flesniak/avr-djc/README.md

avr-djc
=======

Firmware for self-made MIDI DJ controller using AVR µC and V-USB
