flesniak/avr-djc/(threads)

Thread 1 (2020-02-21):

Need help

4dvn, 2020-02-21:
Can you upload the schematic and image of this board?

flesniak, 2020-02-23:
Sure, I just added schematic and board files in commit e737ecb69fb5c8c25f893. Beware that these files may contain errors and should be used for referene only, as they were just used for one prototype.

Closed 2020-02-23.
