flesniak/avr-djc/hw/buttonboard-center.brd

## EAGLE design hw/buttonboard-center.brd (2020-02-23)

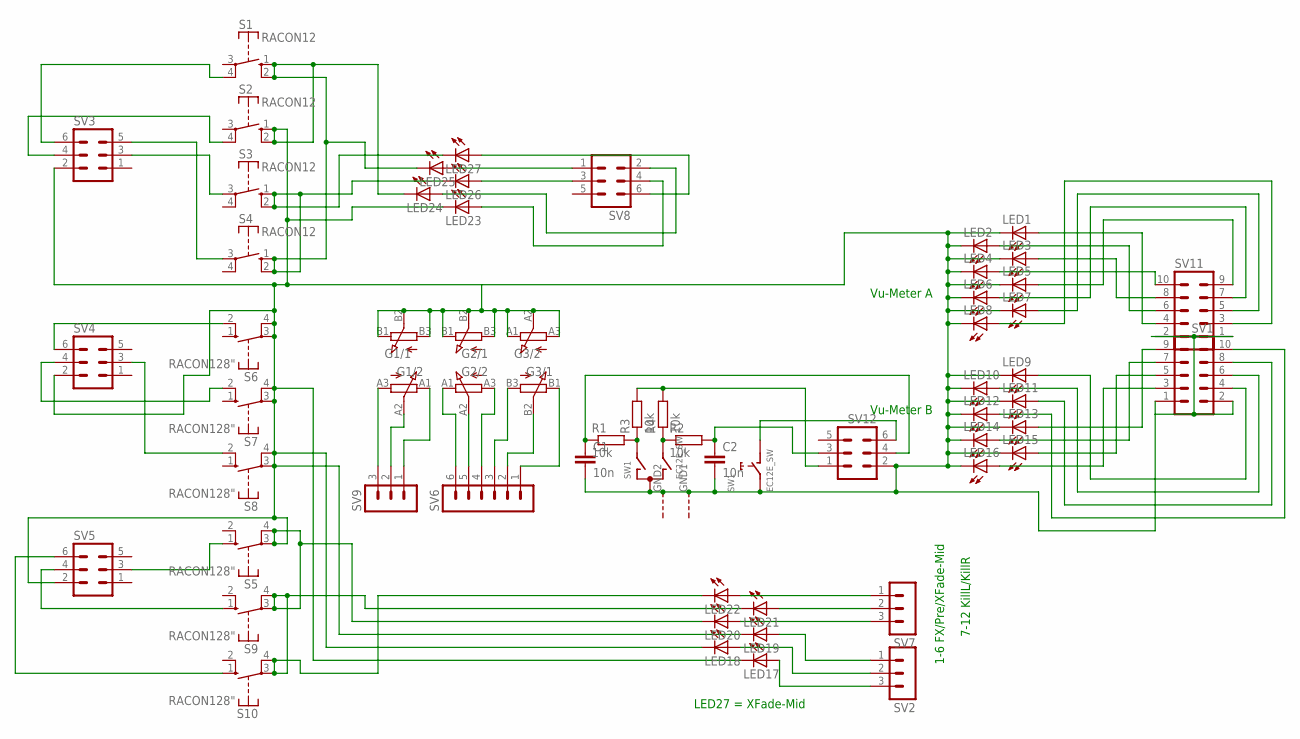
[picture p1: schematic buttonboard-center.sch]

Parts:
C1, C2: 10n; C025-025X050
G1, G2, G3: RS60112RS; RS60112
LED1, LED2, LED3, LED4, LED5, LED6, LED7, LED8, LED9, LED10, LED11, LED12, LED13, LED14, LED15, LED16, LED17, LED18, LED19, LED20, LED21, LED22, LED23, LED24, LED25, LED26, LED27: LED3MM
R1, R2, R3, R4: 10k; 0207/7
S1, S2, S3, S4: RACON12
S5, S6, S7, S8, S9, S10: RACON128"; RACON8
SV1, SV11: MA05-2
SV2, SV7, SV9: MA03-1
SV3, SV4, SV5, SV8, SV12: MA03-2
SV6: MA06-1
SW1: EC12E_SW; ALPS_EC12E_SW

Connections:
GND: C1.2, C2.2, G1.B1 (E), G1.B2 (S), G1.B3 (A), G2.B1 (E), G2.B2 (S), G2.B3 (A), G3.A1 (E), G3.A2 (S), G3.A3 (A), LED1.K (C), LED2.K (C), LED3.K (C), LED4.K (C), LED5.K (C), LED6.K (C), LED7.K (C), LED8.K (C), LED9.K (C), LED10.K (C), LED11.K (C), LED12.K (C), LED13.K (C), LED14.K (C), LED15.K (C), LED16.K (C), LED17.K (C), LED18.K (C), LED19.K (C), LED20.K (C), LED21.K (C), LED22.K (C), LED23.K (C), LED24.K (C), LED25.K (C), LED26.K (C), LED27.K (C), S1.1 (S), S1.2 (S), S2.1 (S), S2.2 (S), S3.1 (S), S3.2 (S), S4.1 (S), S4.2 (S), S5.3, S5.4, S6.3, S6.4, S7.3, S7.4, S8.3, S8.4, S9.3, S9.4, S10.3, S10.4, SV1.1, SV1.2, SV3.2, SV4.2, SV5.2, SV11.1, SV11.2, SV12.2, SW1.C, SW1.E (2), SW1.GND1 (G), SW1.GND2 (G)
unnamed: R1.2, R3.1, SW1.A
unnamed: LED16.A, SV1.3
unnamed: LED15.A, SV1.5
unnamed: LED14.A, SV1.7
unnamed: LED13.A, SV1.9
unnamed: LED12.A, SV1.10
unnamed: LED11.A, SV1.8
unnamed: LED10.A, SV1.6
unnamed: LED9.A, SV1.4
unnamed: LED8.A, SV11.3
unnamed: LED7.A, SV11.5
unnamed: LED6.A, SV11.7
unnamed: LED5.A, SV11.9
unnamed: LED4.A, SV11.10
unnamed: LED3.A, SV11.8
unnamed: R2.1, R4.1, SW1.B
unnamed: C1.1, R1.1, SV12.4
unnamed: LED2.A, SV11.6
unnamed: LED1.A, SV11.4
unnamed: LED17.A, SV2.3
unnamed: LED18.A, SV2.2
unnamed: LED19.A, SV2.1
unnamed: LED20.A, SV7.3
unnamed: LED21.A, SV7.2
unnamed: LED22.A, SV7.1
unnamed: LED24.A, SV8.2
unnamed: SV12.6, SW1.D (1)
unnamed: LED25.A, SV8.1
unnamed: S3.3, SV3.3
unnamed: LED23.A, SV8.4
unnamed: S2.4, SV3.4
unnamed: S1.4, SV3.6
unnamed: C2.1, R2.2, SV12.3
unnamed: R3.2, R4.2, SV12.1
unnamed: LED26.A, SV8.3
unnamed: S6.2 (S), SV4.6
unnamed: LED27.A, SV8.6
unnamed: S4.3, SV3.5
unnamed: S5.1 (S), SV5.3
unnamed: G1.A3 (A), SV9.3
unnamed: G1.A2 (S), SV9.2
unnamed: G1.A1 (E), SV9.1
unnamed: G2.A1 (E), SV6.6
unnamed: G2.A2 (S), SV6.5
unnamed: G2.A3 (A), SV6.4
unnamed: G3.B3 (A), SV6.3
unnamed: G3.B2 (S), SV6.2
unnamed: G3.B1 (E), SV6.1
unnamed: S9.1 (S), SV5.4
unnamed: S7.2 (S), SV4.4
unnamed: S8.2 (S), SV4.3
unnamed: S10.1 (S), SV5.6

Notes on the sheet:
Vu-Meter A
Vu-Meter B
LED27 = XFade-Mid
1-6 FX/Pre/XFade-Mid
7-12 KillL/KillR

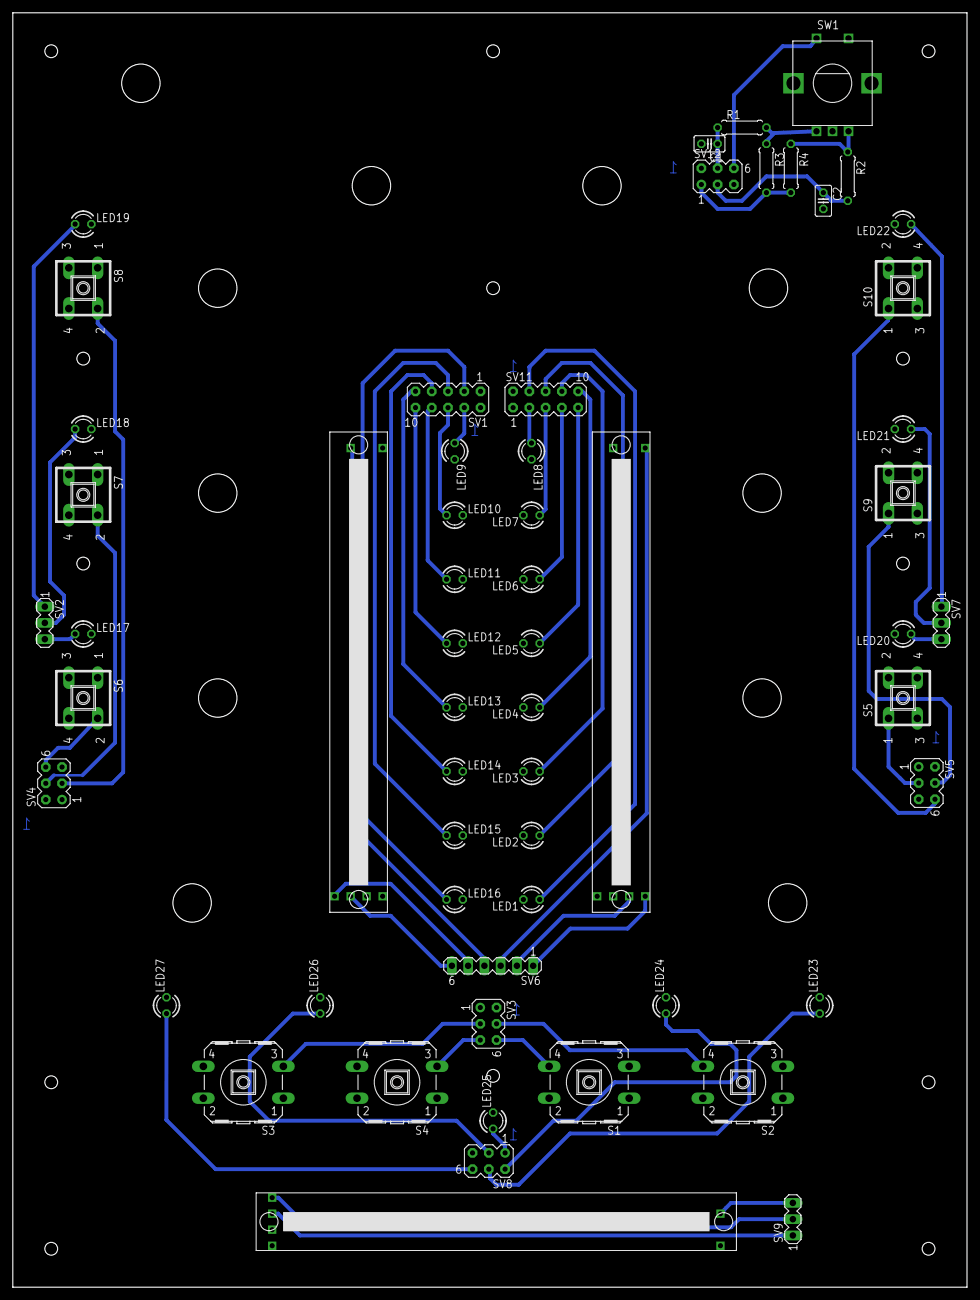
[picture p2: board buttonboard-center.brd from above]

Board: 2 copper layers, 149.0 x 199.0 mm, 58 parts (0 on the bottom side), 53 nets.
