flesniak/avr-djc/hw/main.brd

## EAGLE design hw/main.brd (2020-02-23)

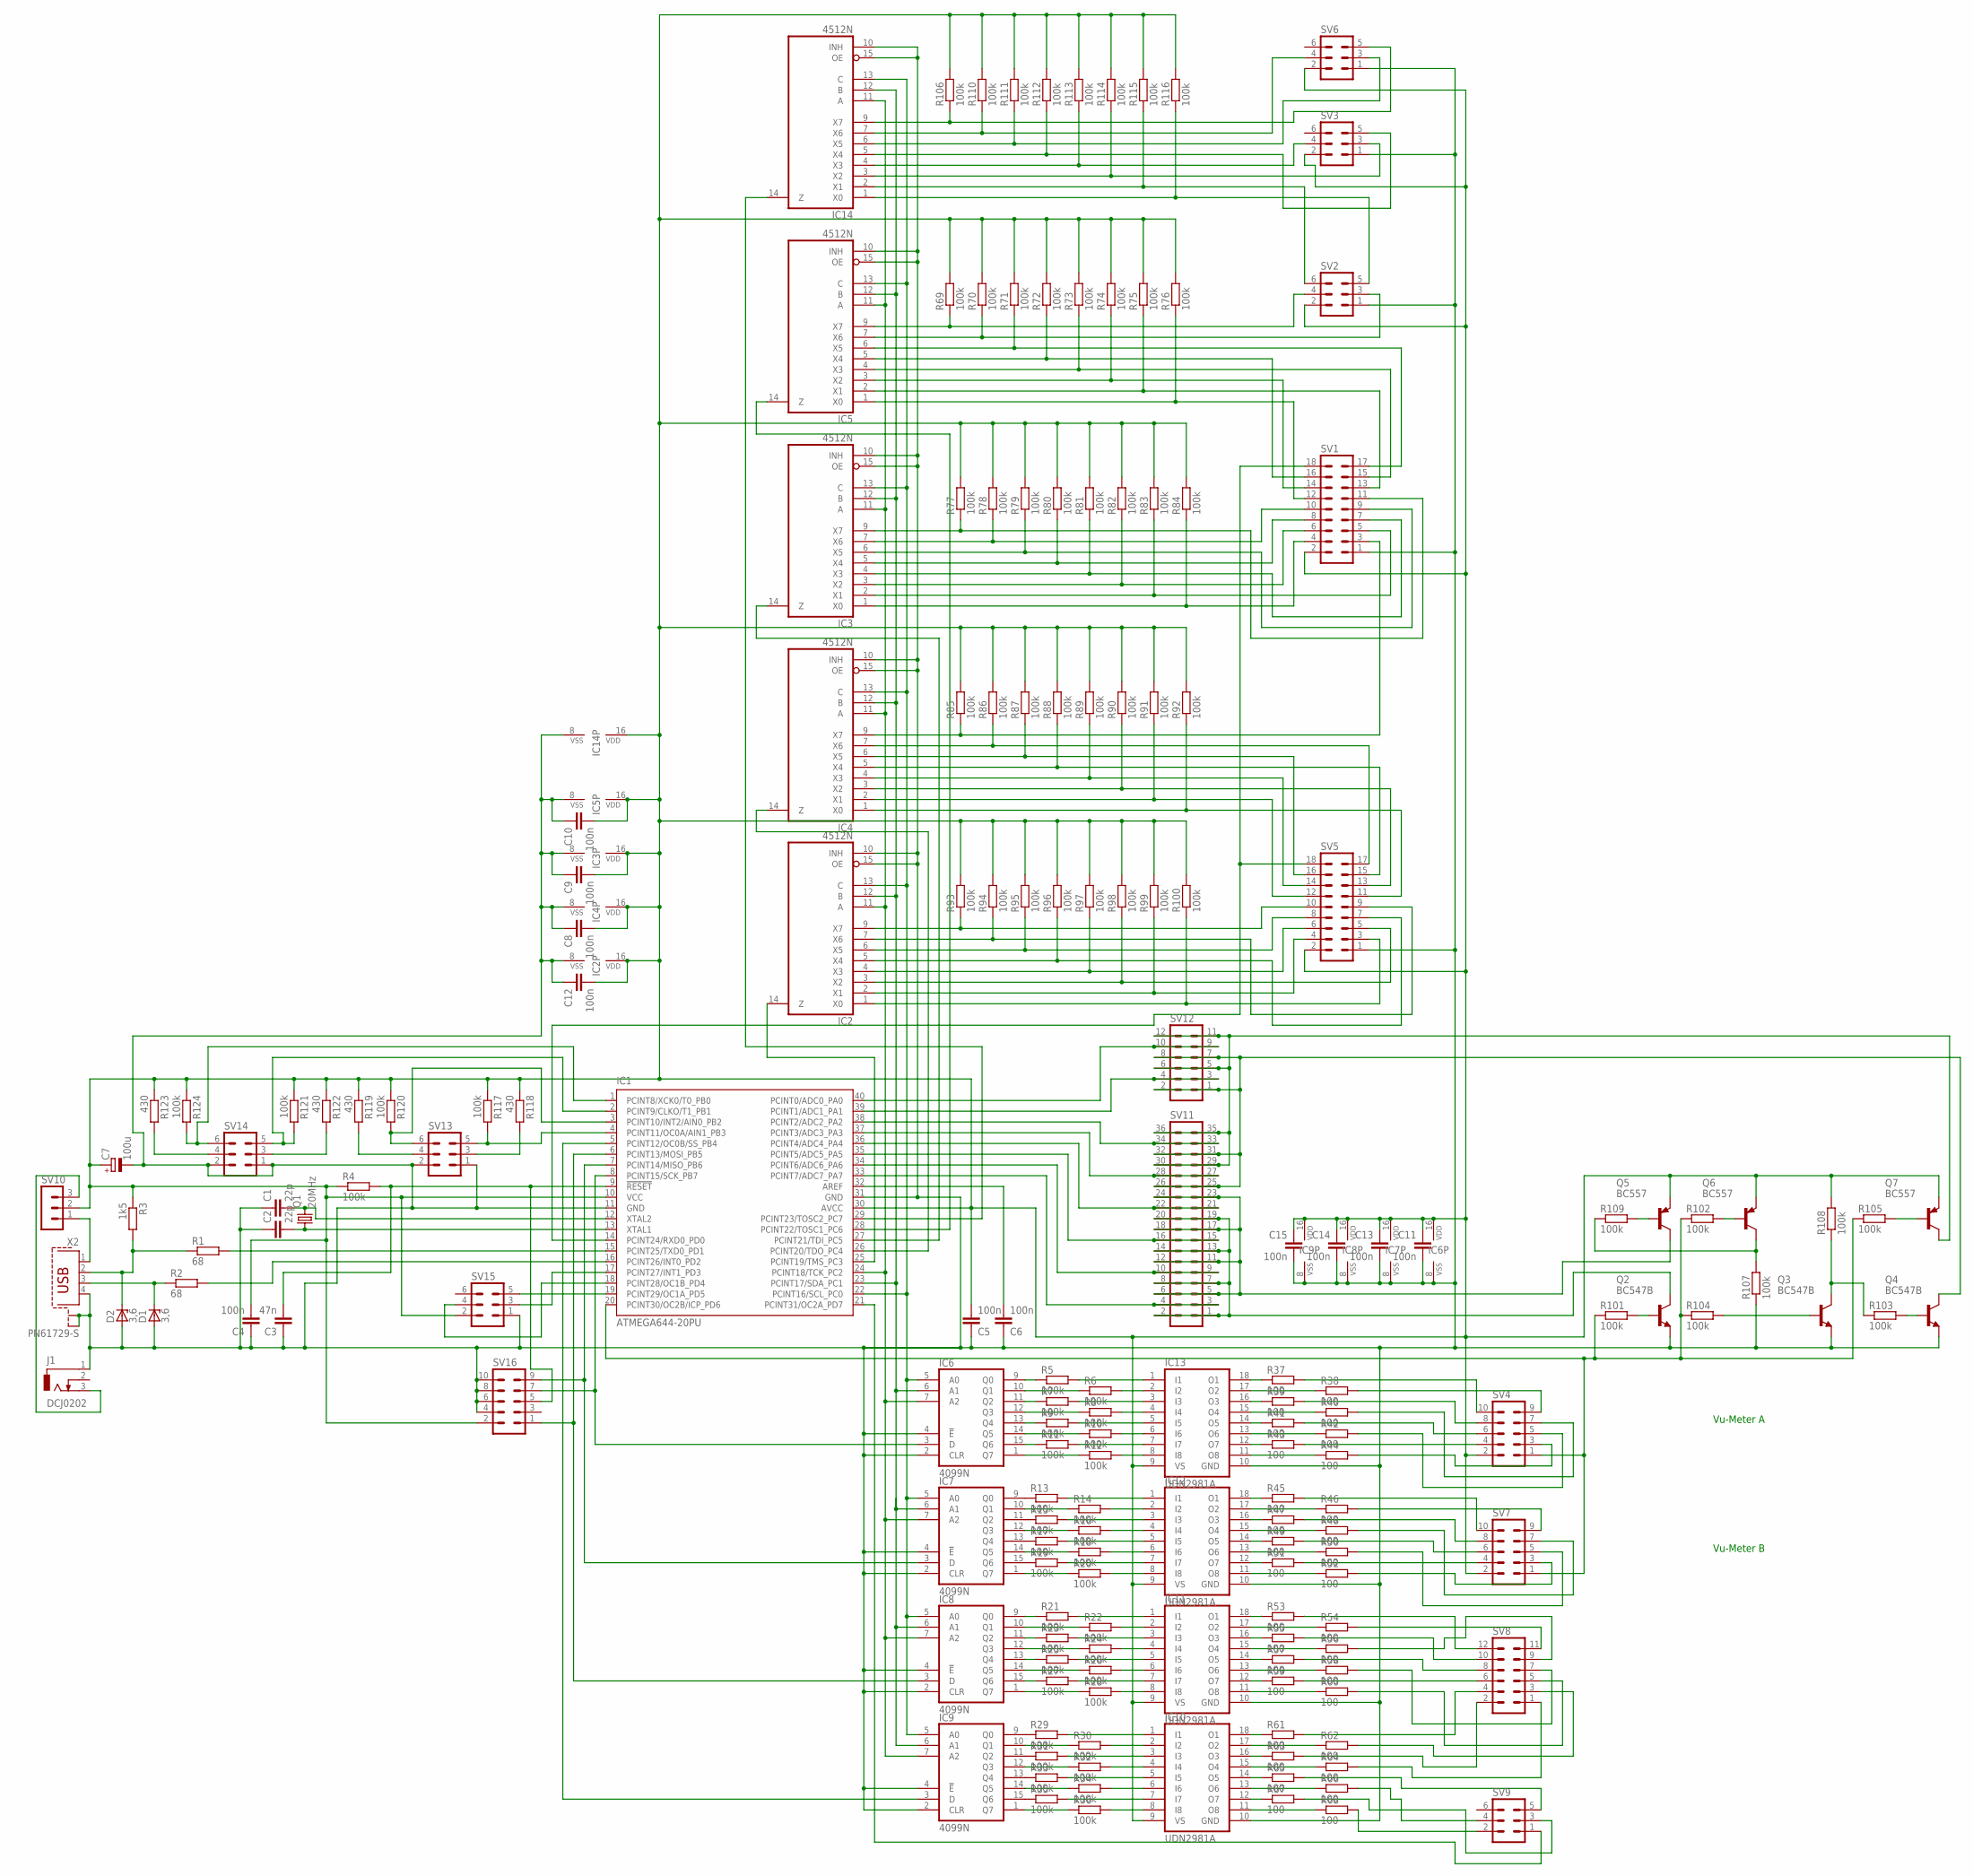
[picture p3: schematic main.sch]

Parts:
C1, C2: 22p; C025-024X044
C3: 47n; C025-024X044
C4, C5, C6, C8, C9, C10, C11, C12, C13, C14, C15: 100n; C025-024X044
C7: 100u; E3,5-8
D1, D2: 3,6; DO34Z7
IC1: ATMEGA644-20PU; DIL40
IC2, IC3, IC4, IC5, IC14: 4512N; DIL16
IC6, IC7, IC8, IC9: 4099N; DIL16
IC10, IC11, IC12, IC13: UDN2981A; DIL18
J1: DCJ0202
Q1: 20MHz; HC18U-V
Q2, Q3, Q4: BC547B; TO92
Q5, Q6, Q7: BC557; TO92
R1, R2: 68; 0204/7
R3: 1k5; 0204/7
R4, R5, R6, R7, R8, R9, R10, R11, R12, R13, R14, R15, R16, R17, R18, R19, R20, R21, R22, R23, R24, R25, R26, R27, R28, R29, R30, R31, R32, R33, R34, R35, R36, R69, R70, R71, R72, R73, R74, R75, R76, R77, R78, R79, R80, R81, R82, R83, R84, R85, R86, R87, R88, R89, R90, R91, R92, R93, R94, R95, R96, R97, R98, R99, R100, R101, R102, R103, R104, R105, R106, R107, R108, R109, R110, R111, R112, R113, R114, R115, R116, R117, R120, R121, R124: 100k; 0204/7
R37, R38, R39, R40, R41, R42, R43, R44, R45, R46, R47, R48, R49, R50, R51, R52, R53, R54, R55, R56, R57, R58, R59, R60, R61, R62, R63, R64, R65, R66, R67, R68: 100; 0204/7
R118, R119, R122, R123: 430; 0204/7
SV1, SV5: MA09-2
SV2, SV3, SV6, SV9, SV13, SV14, SV15: MA03-2
SV4, SV7, SV16: MA05-2
SV8, SV12: MA06-2
SV10: MA03-1
SV11: MA18-2
X2: PN61729-S

Connections:
GND: C1.1, C2.1, C3.1, C4.1, C5.1, C6.1, C7.-, C8.1, C9.1, C10.1, C11.2, C12.1, C13.2, C14.2, C15.2, D1.A, D2.A, IC1.11 (GND), IC1.31 (GND), IC2.8 (VSS), IC2.10 (INH), IC2.15 (OE), IC3.8 (VSS), IC3.10 (INH), IC3.15 (OE), IC4.8 (VSS), IC4.10 (INH), IC4.15 (OE), IC5.8 (VSS), IC5.10 (INH), IC5.15 (OE), IC6.2 (CLR), IC6.4 (!E), IC6.8 (VSS), IC7.2 (CLR), IC7.4 (!E), IC7.8 (VSS), IC8.2 (CLR), IC8.4 (!E), IC8.8 (VSS), IC9.2 (CLR), IC9.4 (!E), IC9.8 (VSS), IC10.10 (GND), IC11.10 (GND), IC12.10 (GND), IC13.10 (GND), IC14.8 (VSS), IC14.10 (INH), IC14.15 (OE), J1.1, Q2.1 (E), Q3.1 (E), Q4.1 (E), R107.1, SV1.1, SV2.1, SV3.1, SV5.1, SV6.1, SV13.1, SV13.2, SV14.1, SV14.2, SV15.1, SV16.4, SV16.6, SV16.8, SV16.10, X2.4, X2.S1, X2.S2
unnamed: IC4.9 (X7), R85.1, SV1.3
unnamed: C2.2, IC1.13 (XTAL1), Q1.1
unnamed: C1.2, IC1.12 (XTAL2), Q1.2
unnamed: IC1.14 (PCINT24/RXD0_PD0), SV1.18, SV5.18
unnamed: D1.C, R2.1, X2.3
unnamed: D2.C, R1.1, R3.2, X2.2
unnamed: IC1.16 (PCINT26/INT0_PD2), R2.2
unnamed: IC1.15 (PCINT25/TXD0_PD1), R1.2
unnamed: C3.2, IC1.9 (!RESET), R4.2, SV16.5
unnamed: IC7.9 (Q0), R13.1
unnamed: IC7.11 (Q2), R15.1
unnamed: C6.2, IC1.32 (AREF)
unnamed: IC7.13 (Q4), R17.1
unnamed: IC7.15 (Q6), R19.1
unnamed: IC1.6 (PCINT13/MOSI_PB5), IC8.3 (D), SV16.1
unnamed: IC1.5 (PCINT12/OC0B/SS_PB4), IC9.3 (D)
unnamed: IC1.23 (PCINT17/SDA_PC1), IC2.12 (B), IC3.12 (B), IC4.12 (B), IC5.12 (B), IC6.6 (A1), IC7.6 (A1), IC8.6 (A1), IC9.6 (A1), IC14.12 (B)
unnamed: IC1.22 (PCINT16/SCL_PC0), IC2.13 (C), IC3.13 (C), IC4.13 (C), IC5.13 (C), IC6.5 (A0), IC7.5 (A0), IC8.5 (A0), IC9.5 (A0), IC14.13 (C)
unnamed: IC1.24 (PCINT18/TCK_PC2), IC2.11 (A), IC3.11 (A), IC4.11 (A), IC5.11 (A), IC6.7 (A2), IC7.7 (A2), IC8.7 (A2), IC9.7 (A2), IC14.11 (A)
unnamed: IC8.9 (Q0), R21.1
unnamed: IC8.10 (Q1), R22.1
unnamed: IC8.11 (Q2), R23.1
unnamed: IC8.12 (Q3), R24.1
unnamed: IC1.27 (PCINT21/TDI_PC5), IC3.14 (Z)
unnamed: IC1.25 (PCINT19/TMS_PC3), IC2.14 (Z)
unnamed: IC3.6 (X5), R79.1, SV1.9
unnamed: IC3.9 (X7), R77.1, SV1.11
unnamed: IC12.12 (O7), R51.1
unnamed: IC8.13 (Q4), R25.1
unnamed: IC8.14 (Q5), R26.1
unnamed: IC8.15 (Q6), R27.1
unnamed: IC8.1 (Q7), R28.1
unnamed: IC13.8 (I8), R12.2
unnamed: IC13.7 (I7), R11.2
unnamed: IC13.6 (I6), R10.2
unnamed: IC13.5 (I5), R9.2
unnamed: IC13.4 (I4), R8.2
unnamed: IC13.3 (I3), R7.2
unnamed: IC13.2 (I2), R6.2
unnamed: IC13.1 (I1), R5.2
unnamed: IC10.1 (I1), R29.2
unnamed: IC10.2 (I2), R30.2
unnamed: IC10.3 (I3), R31.2
unnamed: IC10.4 (I4), R32.2
unnamed: IC10.5 (I5), R33.2
unnamed: IC10.6 (I6), R34.2
unnamed: IC10.7 (I7), R35.2
unnamed: IC10.8 (I8), R36.2
unnamed: IC9.10 (Q1), R30.1
unnamed: IC9.12 (Q3), R32.1
unnamed: IC9.14 (Q5), R34.1
unnamed: IC9.1 (Q7), R36.1
unnamed: IC11.1 (I1), R21.2
unnamed: IC9.9 (Q0), R29.1
unnamed: IC9.11 (Q2), R31.1
unnamed: IC1.28 (PCINT22/TOSC1_PC6), IC5.14 (Z)
unnamed: IC1.26 (PCINT20/TDO_PC4), IC4.14 (Z)
unnamed: IC9.13 (Q4), R33.1
unnamed: IC11.2 (I2), R22.2
unnamed: IC9.15 (Q6), R35.1
unnamed: IC11.3 (I3), R23.2
unnamed: IC11.4 (I4), R24.2
unnamed: IC1.8 (PCINT15/SCK_PB7), IC6.3 (D), SV16.7
unnamed: IC1.7 (PCINT14/MISO_PB6), IC7.3 (D), SV16.9
unnamed: IC11.5 (I5), R25.2
unnamed: IC11.6 (I6), R26.2
unnamed: IC11.7 (I7), R27.2
unnamed: IC6.9 (Q0), R5.1
unnamed: IC6.10 (Q1), R6.1
unnamed: IC6.11 (Q2), R7.1
unnamed: IC6.12 (Q3), R8.1
unnamed: IC6.13 (Q4), R9.1
unnamed: IC6.14 (Q5), R10.1
unnamed: IC6.15 (Q6), R11.1
unnamed: IC6.1 (Q7), R12.1
unnamed: IC11.8 (I8), R28.2
unnamed: IC13.18 (O1), R37.1
unnamed: IC13.17 (O2), R38.1
unnamed: R37.2, SV4.10
unnamed: R38.2, SV4.9
unnamed: IC5.9 (X7), R69.1, SV2.4
unnamed: R53.2, SV8.12
unnamed: R39.2, SV4.8
unnamed: IC12.1 (I1), R13.2
unnamed: IC12.2 (I2), R14.2
unnamed: IC12.3 (I3), R15.2
unnamed: IC12.4 (I4), R16.2
unnamed: IC12.5 (I5), R17.2
unnamed: IC12.6 (I6), R18.2
unnamed: IC12.7 (I7), R19.2
unnamed: IC12.8 (I8), R20.2
unnamed: IC7.10 (Q1), R14.1
unnamed: IC7.12 (Q3), R16.1
unnamed: IC13.16 (O3), R39.1
unnamed: IC13.15 (O4), R40.1
unnamed: R40.2, SV4.7
unnamed: R41.2, SV4.6
unnamed: IC5.6 (X5), R71.1, SV1.17
unnamed: IC7.14 (Q5), R18.1
unnamed: IC7.1 (Q7), R20.1
unnamed: IC3.4 (X3), R81.1, SV1.7
unnamed: IC13.14 (O5), R41.1
unnamed: IC13.13 (O6), R42.1
unnamed: R42.2, SV4.5
unnamed: R43.2, SV4.4
unnamed: IC5.4 (X3), R73.1, SV1.15
unnamed: IC3.2 (X1), R83.1, SV1.5
unnamed: IC13.12 (O7), R43.1
unnamed: IC13.11 (O8), R44.1
unnamed: IC12.13 (O6), R50.1
unnamed: IC5.2 (X1), R75.1, SV1.13
unnamed: R54.2, SV8.11
unnamed: IC3.3 (X2), R82.1, SV1.6
unnamed: IC12.18 (O1), R45.1
unnamed: IC12.17 (O2), R46.1
unnamed: R44.2, SV4.3
unnamed: J1.3, SV10.3
unnamed: IC12.16 (O3), R47.1
unnamed: IC12.15 (O4), R48.1
unnamed: R45.2, SV7.10
unnamed: R46.2, SV7.9
unnamed: IC12.14 (O5), R49.1
unnamed: IC11.12 (O7), R59.1
unnamed: R47.2, SV7.8
unnamed: R48.2, SV7.7
unnamed: R55.2, SV8.10
unnamed: R49.2, SV7.6
unnamed: R50.2, SV7.5
unnamed: IC12.11 (O8), R52.1
unnamed: R51.2, SV7.4
unnamed: IC11.18 (O1), R53.1
unnamed: IC11.17 (O2), R54.1
unnamed: R52.2, SV7.3
unnamed: IC5.7 (X6), R70.1, SV2.3
unnamed: IC11.16 (O3), R55.1
unnamed: IC11.15 (O4), R56.1
unnamed: IC1.33 (PCINT7/ADC7_PA7), SV11.3, SV11.4
unnamed: IC3.1 (X0), R84.1, SV1.4
unnamed: IC11.14 (O5), R57.1
unnamed: IC11.13 (O6), R58.1
unnamed: R56.2, SV8.9
unnamed: R57.2, SV8.8
unnamed: R58.2, SV8.7
unnamed: R59.2, SV8.6
unnamed: R60.2, SV8.5
unnamed: IC11.11 (O8), R60.1
unnamed: R61.2, SV8.4
unnamed: IC10.18 (O1), R61.1
unnamed: IC10.17 (O2), R62.1
unnamed: R62.2, SV8.3
unnamed: IC1.34 (PCINT6/ADC6_PA6), SV11.9, SV11.10
unnamed: IC10.16 (O3), R63.1
unnamed: IC10.15 (O4), R64.1
unnamed: IC4.7 (X6), R86.1, SV5.17
unnamed: IC4.6 (X5), R87.1, SV5.16
unnamed: IC10.14 (O5), R65.1
unnamed: IC10.13 (O6), R66.1
unnamed: IC4.5 (X4), R88.1, SV5.15
unnamed: IC4.4 (X3), R89.1, SV5.14
unnamed: IC10.12 (O7), R67.1
unnamed: IC4.3 (X2), R90.1, SV5.13
unnamed: IC1.29 (PCINT23/TOSC2_PC7), IC14.14 (Z)
unnamed: IC10.11 (O8), R68.1
unnamed: IC5.5 (X4), R72.1, SV1.16
unnamed: IC4.2 (X1), R91.1, SV5.12
unnamed: R63.2, SV8.2
unnamed: IC4.1 (X0), R92.1, SV5.11
unnamed: IC2.9 (X7), R93.1, SV5.10
unnamed: IC2.7 (X6), R94.1, SV5.9
unnamed: IC2.6 (X5), R95.1, SV5.8
unnamed: IC14.9 (X7), R106.1, SV6.5
unnamed: IC2.5 (X4), R96.1, SV5.7
unnamed: IC14.7 (X6), R110.1, SV6.4
unnamed: IC14.6 (X5), R111.1, SV6.3
unnamed: IC14.4 (X3), R113.1, SV3.4
unnamed: IC14.2 (X1), R115.1, SV2.6
unnamed: IC2.4 (X3), R97.1, SV5.6
unnamed: IC2.3 (X2), R98.1, SV5.5
unnamed: R64.2, SV8.1
unnamed: IC2.2 (X1), R99.1, SV5.4
unnamed: R65.2, SV9.5
unnamed: IC2.1 (X0), R100.1, SV5.3
unnamed: R66.2, SV9.4
unnamed: IC3.7 (X6), R78.1, SV1.10
unnamed: IC1.20 (PCINT30/OC2B/ICP_PD6), R101.1, R102.1, R104.1, R105.1, SV4.1, SV7.1
unnamed: Q6.2 (B), R102.2
unnamed: R67.2, SV9.3
unnamed: IC14.5 (X4), R112.1, SV3.5
unnamed: Q7.2 (B), R105.2
unnamed: IC14.3 (X2), R114.1, SV3.3
unnamed: IC14.1 (X0), R116.1, SV2.5
unnamed: Q2.2 (B), R101.2
unnamed: R68.2, SV9.2
unnamed: IC3.5 (X4), R80.1, SV1.8
unnamed: Q3.2 (B), R104.2
unnamed: Q6.3 (C), R107.2, R109.1
unnamed: Q3.3 (C), R103.1, R108.1
unnamed: Q4.2 (B), R103.2
unnamed: Q5.2 (B), R109.2
unnamed: IC1.21 (PCINT31/OC2A_PD7), SV9.1
unnamed: IC1.4 (PCINT11/OC0A/AIN1_PB3), R117.2, SV13.5
unnamed: R118.2, SV13.3
unnamed: IC1.3 (PCINT10/INT2/AIN0_PB2), R120.2, SV13.6
unnamed: IC1.35 (PCINT5/ADC5_PA5), SV11.15, SV11.16
unnamed: R119.2, SV13.4
unnamed: IC1.2 (PCINT9/CLKO/T1_PB1), R121.2, SV14.5
unnamed: R122.2, SV14.3
unnamed: IC1.1 (PCINT8/XCK0/T0_PB0), R124.2, SV14.6
unnamed: SV10.1, X2.1
unnamed: IC1.36 (PCINT4/ADC4_PA4), SV11.21, SV11.22
unnamed: IC1.37 (PCINT3/ADC3_PA3), SV11.27, SV11.28
unnamed: R123.2, SV14.4
unnamed: IC1.38 (PCINT2/ADC2_PA2), SV11.33, SV11.34
unnamed: IC5.3 (X2), R74.1, SV1.14
unnamed: IC1.39 (PCINT1/ADC1_PA1), SV12.3, SV12.4
unnamed: IC5.1 (X0), R76.1, SV1.12
unnamed: IC1.40 (PCINT0/ADC0_PA0), SV12.9, SV12.10
unnamed: Q4.3 (C), SV11.25, SV11.26, SV11.31, SV11.32, SV12.1, SV12.2, SV12.7, SV12.8
unnamed: IC1.18 (PCINT28/OC1B_PD4), SV15.4
unnamed: IC1.19 (PCINT29/OC1A_PD5), SV15.5
unnamed: IC1.17 (PCINT27/INT1_PD3), SV15.3
unnamed: Q5.3 (C), SV11.5, SV11.6, SV11.11, SV11.12, SV11.17, SV11.18, SV11.23, SV11.24
unnamed: Q2.3 (C), SV11.1, SV11.2, SV11.7, SV11.8, SV11.13, SV11.14, SV11.19, SV11.20
unnamed: Q7.3 (C), SV11.29, SV11.30, SV11.35, SV11.36, SV12.5, SV12.6, SV12.11, SV12.12
VCC: C4.2, C5.2, C7.+, C8.2, C9.2, C10.2, C11.1, C12.2, C13.1, C14.1, C15.1, IC1.10 (VCC), IC1.30 (AVCC), IC2.16 (VDD), IC3.16 (VDD), IC4.16 (VDD), IC5.16 (VDD), IC6.16 (VDD), IC7.16 (VDD), IC8.16 (VDD), IC9.16 (VDD), IC10.9 (VS), IC11.9 (VS), IC12.9 (VS), IC13.9 (VS), IC14.16 (VDD), Q5.1 (E), Q6.1 (E), Q7.1 (E), R3.1, R4.1, R69.2, R70.2, R71.2, R72.2, R73.2, R74.2, R75.2, R76.2, R77.2, R78.2, R79.2, R80.2, R81.2, R82.2, R83.2, R84.2, R85.2, R86.2, R87.2, R88.2, R89.2, R90.2, R91.2, R92.2, R93.2, R94.2, R95.2, R96.2, R97.2, R98.2, R99.2, R100.2, R106.2, R108.2, R110.2, R111.2, R112.2, R113.2, R114.2, R115.2, R116.2, R117.1, R118.1, R119.1, R120.1, R121.1, R122.1, R123.1, R124.1, SV1.2, SV2.2, SV3.2, SV4.2, SV5.2, SV6.2, SV7.2, SV10.2, SV15.2, SV16.2

Notes on the sheet:
Vu-Meter A
Vu-Meter B

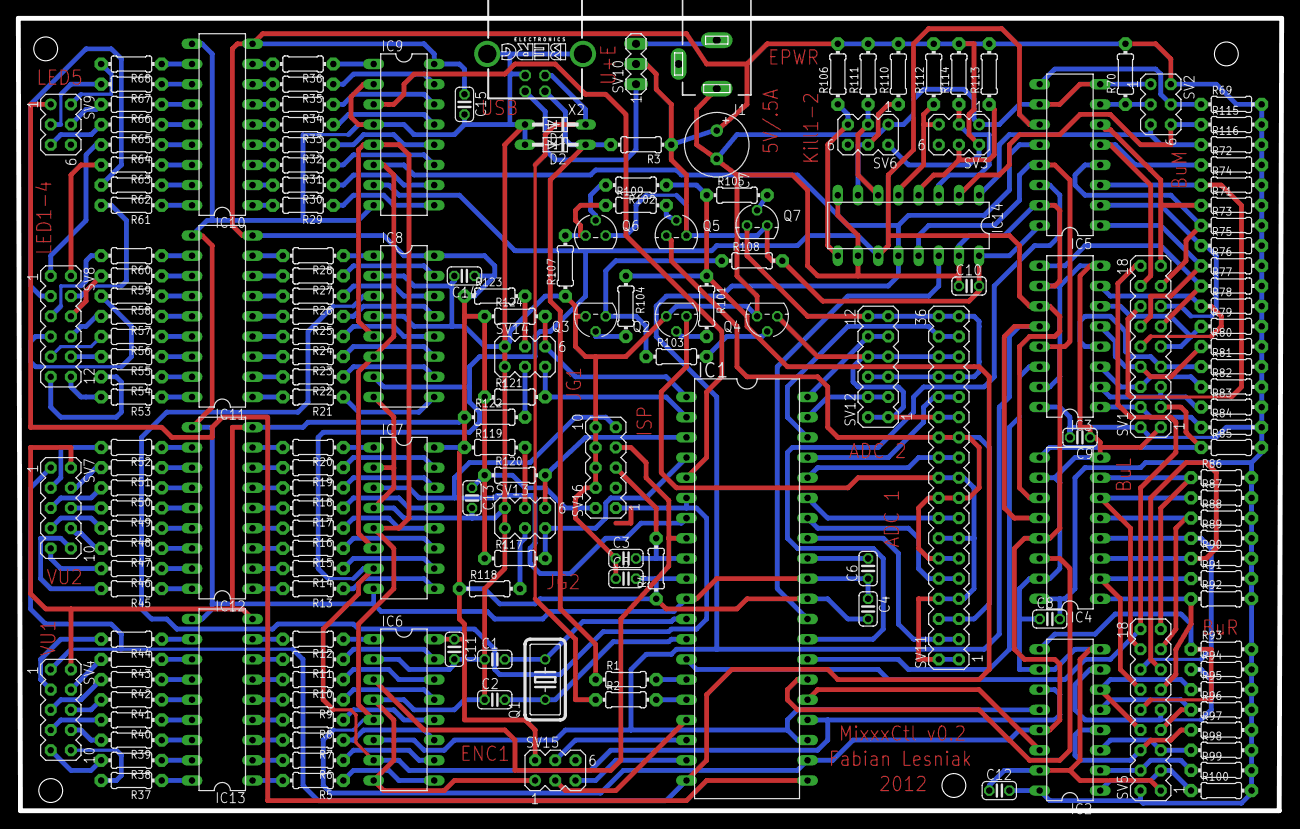
[picture p4: board main.brd from above]

Board: 2 copper layers, 159.0 x 99.7 mm, 180 parts (0 on the bottom side), 226 nets.
