flesniak/avr-djc/hw/buttonboard-right.brd

## EAGLE design hw/buttonboard-right.brd (2020-02-23)

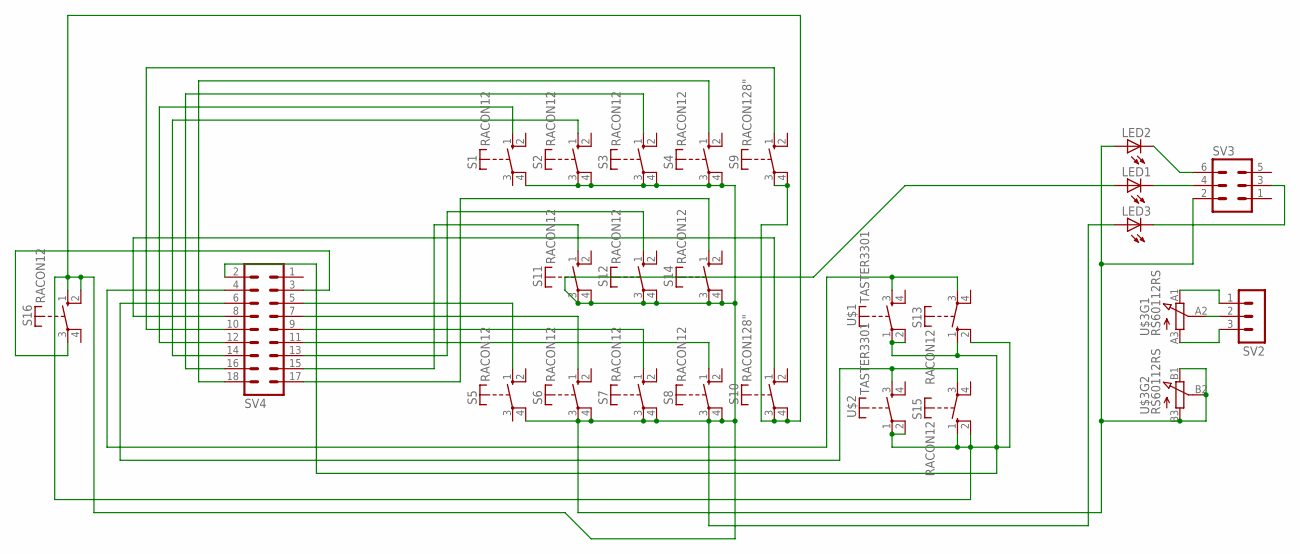
[picture p5: schematic buttonboard-right.sch]

Parts:
LED1, LED2, LED3: LED3MM
S1, S2, S3, S4, S5, S6, S7, S8, S11, S12, S13, S14, S15, S16: RACON12
S9, S10: RACON128"; RACON8
SV2: MA03-1
SV3: MA03-2
SV4: MA09-2
U$1, U$2: TASTER3301; 3301
U$3: RS60112RS; RS60112

Connections:
GND: LED1.A, LED2.A, LED3.A, S1.4, S2.3, S2.4, S3.3, S3.4, S4.3, S4.4, S5.4, S6.3, S6.4, S7.3, S7.4, S8.3, S8.4, S9.3, S9.4, S10.3, S10.4, S11.3, S11.4, S12.3, S12.4, S13.1 (S), S13.2 (S), S14.3, S14.4, S15.1 (S), S15.2 (S), S16.1 (S), S16.2 (S), SV3.2, SV4.2, U$1.1, U$1.2, U$2.1, U$2.2, U$3.B1 (E), U$3.B2 (S), U$3.B3 (A)
unnamed: S10.1 (S), SV4.8
unnamed: S1.1 (S), SV4.12
unnamed: S6.1 (S), SV4.7
unnamed: S2.1 (S), SV4.14
unnamed: S7.1 (S), SV4.9
unnamed: S8.1 (S), SV4.11
unnamed: S5.1 (S), SV4.5
unnamed: S15.3, SV4.6, U$2.3 (S)
unnamed: S3.1 (S), SV4.16
unnamed: S13.3, SV4.4, U$1.3 (S)
unnamed: LED2.K (C), SV3.6
unnamed: LED1.K (C), SV3.4
unnamed: LED3.K (C), SV3.3
unnamed: S4.1 (S), SV4.18
unnamed: SV2.2, U$3.A2 (S)
unnamed: SV2.1, U$3.A1 (E)
unnamed: SV2.3, U$3.A3 (A)
unnamed: S16.3, SV4.3
unnamed: S12.1 (S), SV4.13
unnamed: S9.1 (S), SV4.10
unnamed: S11.1 (S), SV4.15
unnamed: S14.1 (S), SV4.17

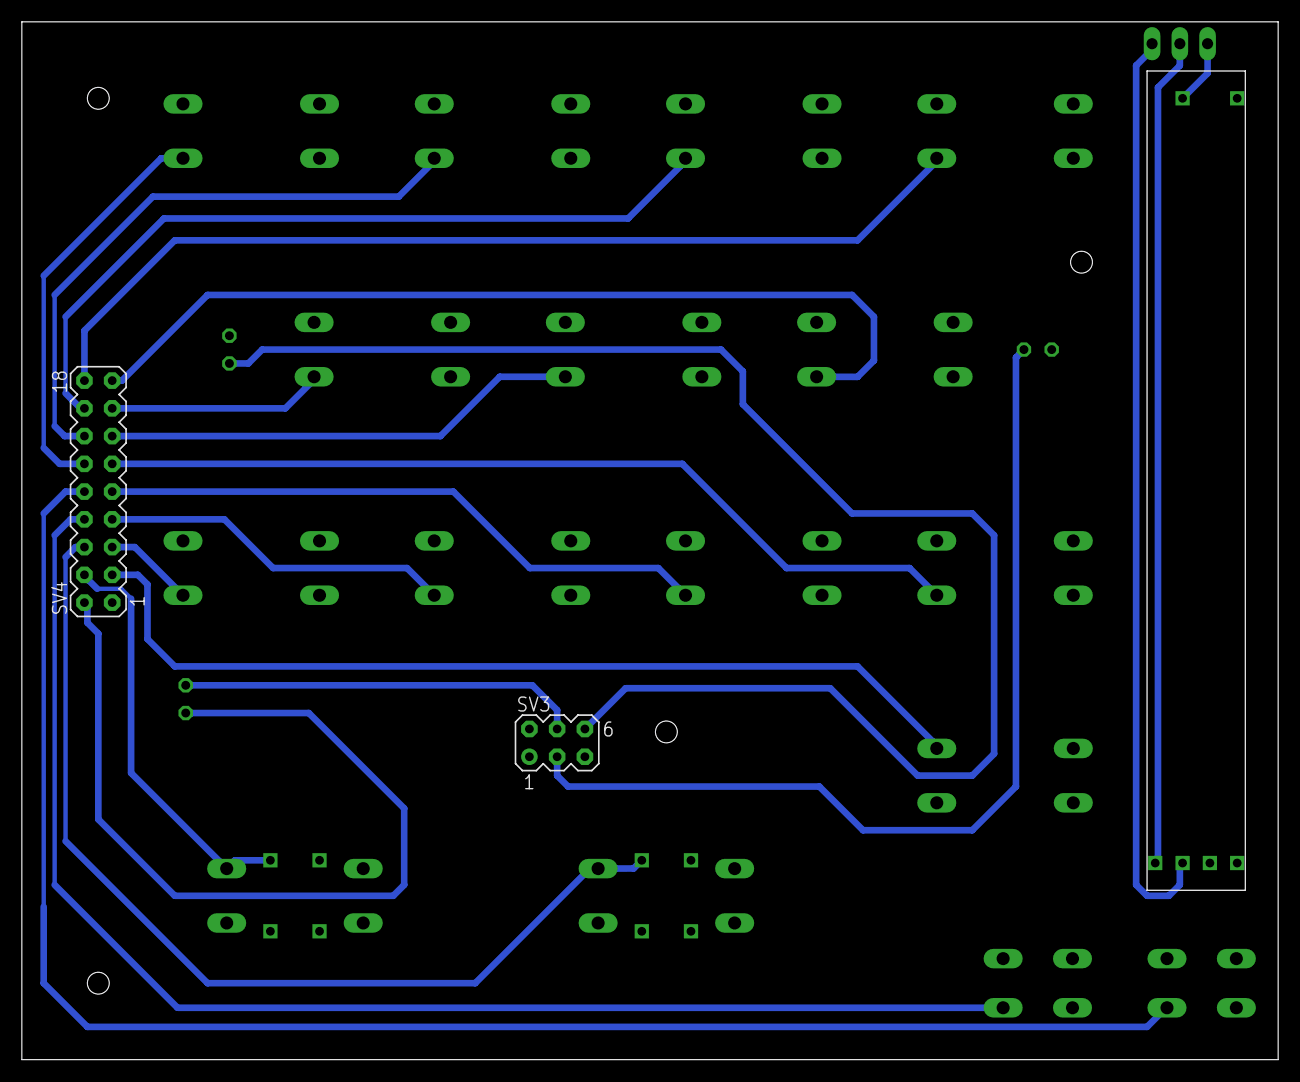
[picture p6: board buttonboard-right.brd from above]

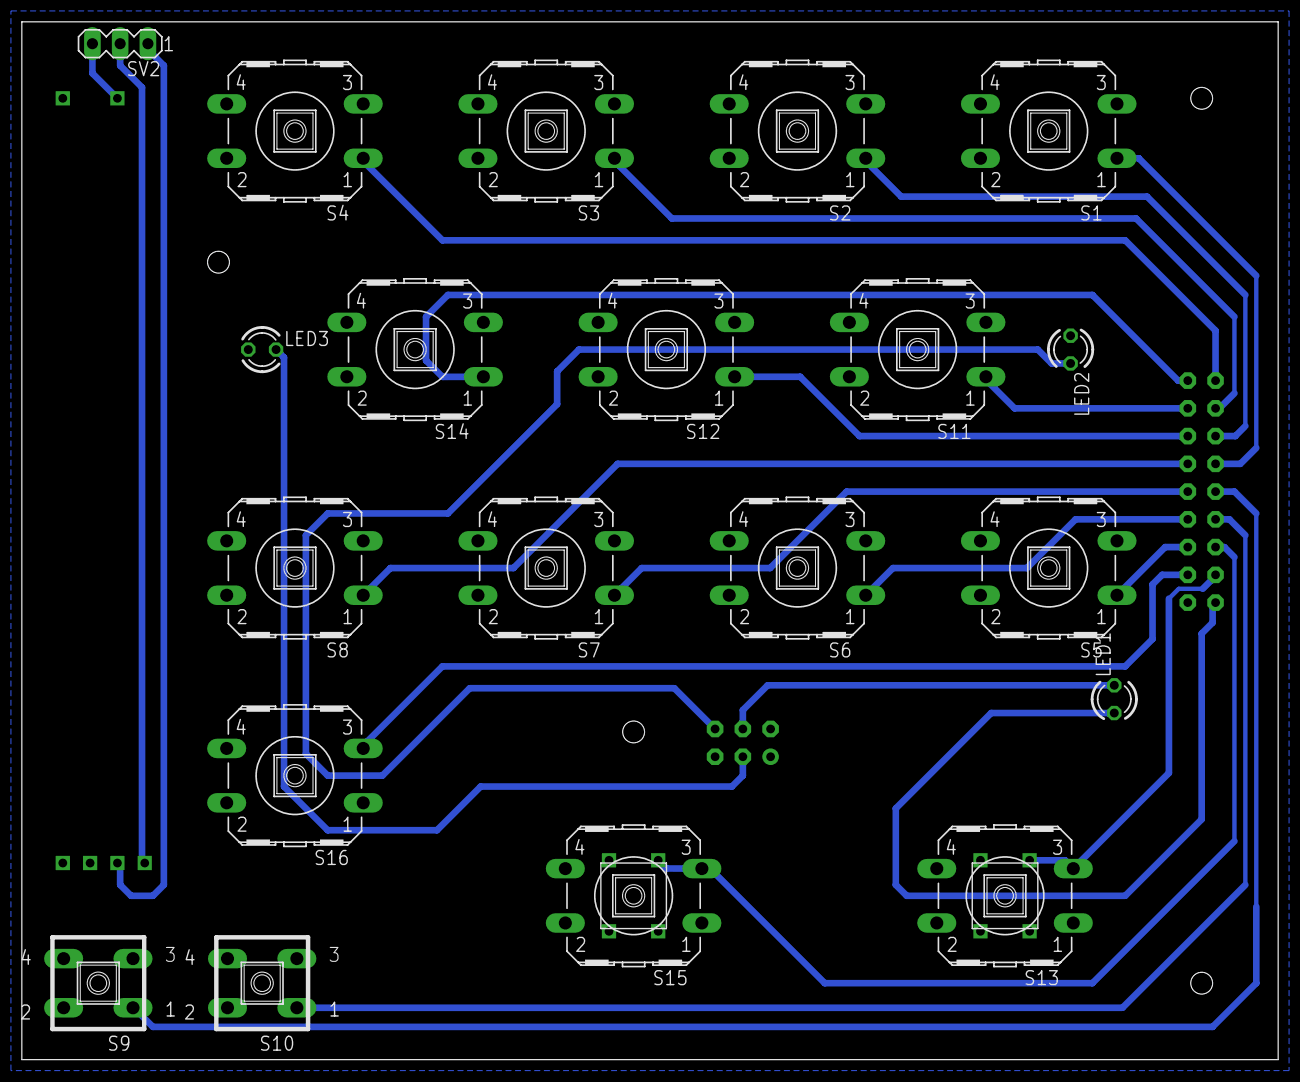
[picture p7: board buttonboard-right.brd from below]

Board: 2 copper layers, 115.0 x 95.0 mm, 25 parts (22 on the bottom side), 23 nets.
