flesniak/avr-djc/(commit log)

2012-07-14 portd pullup resistors fixed
    [djc.c]
2012-07-14 interrupt-triggering for encoder
2013-01-16 moved from ADCCHANGE to LWENABLE/DISABLE macros
    now the led latches' WRITE DISABLE resides on PD6
2013-01-29 ADC conversion updated to changed layout
2013-01-29 buttons, convenient leds, pots working
2013-01-30 xfade led working well
2013-01-31 few fixed + extra files
    -mixxx mappings added
    -led test script added
    -few bugfixes in firmware
    [djc.c]
2013-05-09 4-state vu led logic fix
    [djc.c]
2013-05-14 harddisk jog wheel test
2013-05-15 jog wheel fix
    removed mapping links
    compile script updated
    [djc.c]
2014-07-09 added case front plane
2014-11-17 added makefile
    fixed usbdrv for newer gcc
    removed old compile script
    [descriptors.h, djc.c]
2015-09-24 first final, fully working version
    + re-worked jogwheel code
    + re-worked soft-pwm for vu
    + implemented sysex handling
    + added protocol documentation
    + enhanced makefile
2015-10-12 added mappings and protocol description
    - added mixxx mappings
    - added protocol description
    - improved led test script
    - removed outdated traktor layout
2020-02-23 add schematic and board files of prototype
    Beware that these files may contain errors and should be used for
    referene only.
    [buttonboard-center.brd, buttonboard-center.sch, buttonboard-left.brd, buttonboard-left.sch, buttonboard-right.brd, buttonboard-right.sch, main.brd, main.sch]
